jesari-git/tt10-gus16-jarias/docs/GUS16_tt.pdf

## GUS16-v6 in Silicon

Jesús Arias Alvarez

## 1 Tiny Tapeout projects

Tiny Tapeout provides the education community with an affordable way of making chips, but there are also some constraints you have to be aware of when designing a digital system for these Tiny Tapeout runs, like:

- No memory blocks. On-chip memory takes a lot of silicon space. If your design requires some decent amount of memory (like 1 kilobyte) it is better to attach another memory chip outside the prototype.
- Limited number of pins. Your design gets a clock and reset signals, along with:

– 8 input pins

– 8 output pins

– 8 bidirectional pins

And that’s all.

- Small silicon area. The prototype space is divided into an array of 160×110µm

2
tiles and your design
must fit into an small number of tiles, ideally just one.

## 2 The GUS16-tt system

The Tiny Tapeout constraints were quite challenging, and in order to meet them this GUS16 system has some peculiarities, like:

- The internal memory is reduced to a tiny 32-word ROM, enough space for a simple serial bootloader. ROM memories are combinatorial circuits that can be built with simple logic gates (with an small number of them, let’s hope...)
- An external RAM is mandatory, but the number of pins is also limited. An SPI RAM will require only 4 pins, but it is painfully slow, so here a different solution is presented: A conventional SRAM with an 8-bit data bus and with latches for its address bits. This solution will use the 8 bidirectional pins along with 5 output pins for control. The bad side of this is the 4 clock cycles needed for each memory read or write that results in a processor clock frequency divided by four. Still, this is a lot better than the 48 cycles required for an SPI RAM like the 23LC1024, and leaves 3 output pins and 8 input pins still free.

In figure 1 the blocks of a simple computer built around this prototype chip are displayed. The chip includes a GUS16-v6 core along with several peripherals, the boot ROM, and the external memory interface. We should remark:

- The CPU has an stoppable clock and can be halted when waiting for UART data.

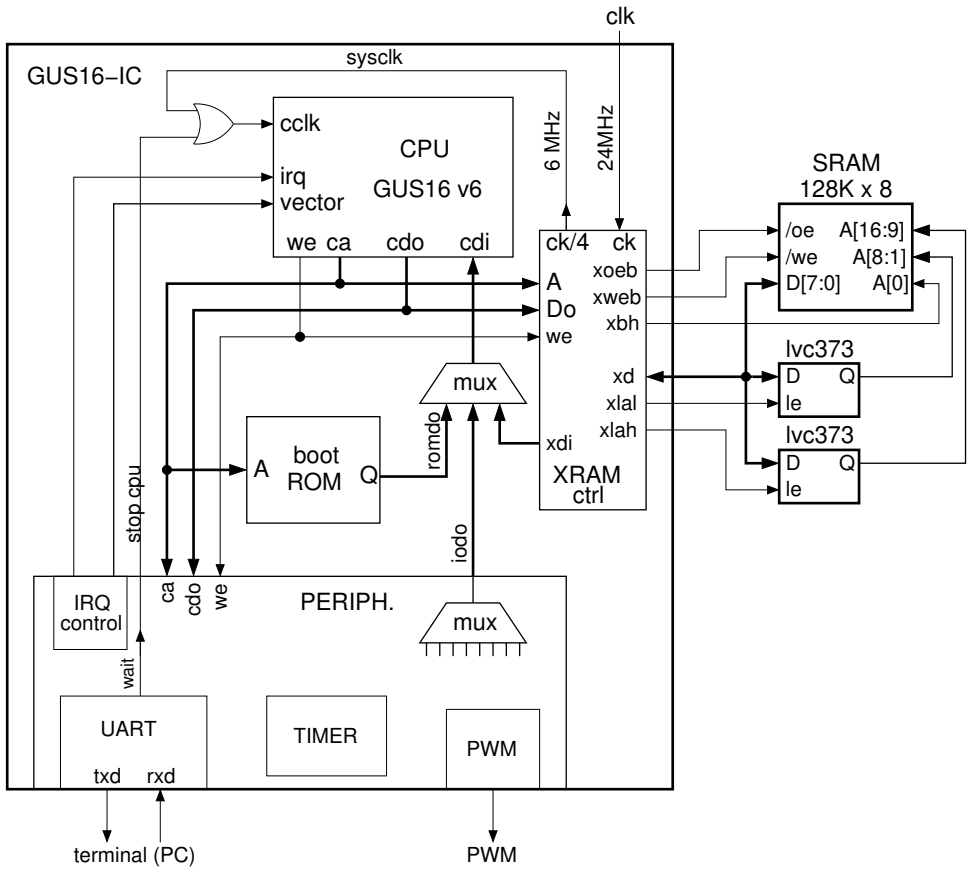
[picture p1: figure]
TIMER; mux; cclk; cdi; vector; irq; CPU GUS16 v6 romdo; cdo; SRAM 128K x 8; xbh; xlal xlah; xweb; xoeb; lvc373; mux iodo; terminal (PC) wait; IRQ control; PERIPH.; GUS16−IC; XRAM ctrl; stop cpu; UART; txd; rxd; PWM; sysclk; boot ROM Q; xdi ⁶ MHz; 24MHz; clk

Figure 1: Block diagram of the GUSY computer.

- A simple UART with a fixed baud rate (default 115200bps) is included as the main computer interface. This peripheral is also a bit peculiar because it can stop the CPU clock. This was done in order to simplify the bootloader code: If the receiver register is read when there is no data available the program execution stalls until a new character arrives at the receiver. In this way there is no need to keep polling an status register until a data available flag is set and the code is more compact. The same happens with the transmitter: if the transmitter register gets written while an old data is still being transmitted the CPU stalls until the new character can be written. Of course, the related flags can also be read in an status register and the usual polling routines do not result in stalls (this can be desirable if there are interrupts enabled).
- A 16-bit timer counter is also included, mainly for profiling and interrupt generation. It includes a fixed prescaler divider that results in a 1 MHz counter frequency (it counts microseconds).
- A simple PWM output (audio DAC) is included.
- The core has five interrupt sources with independent vectors. These sources can be enabled by writing the Interrupt Enable register with ones (all its bits are zeroes after reset). The interrupts have a fixed priority order.

### 2.1 The external memory interface

The GUS16 core has 16-bit address and data buses, but we only got 8 bits for a bidirectional bus where all addresses and data has to pass through. This means that any memory access, read or write, has to take four cycles (see figure 2): First, the low 8 bits of the memory address are presented on the bus and the “latch address

1 | 2 | 3
A[7:0] | A[15:8]

xlah

xlal

xd[7:0]

xbh

sysclk

clk

0

READ CYCLE

high−Z

1 | 2 | 3
A[7:0] | A[15:8] | D[7:0] | D[15:8]

xweb

xlah

xlal

xd[7:0]

xbh

sysclk

clk

WRITE CYCLE

0

xoeb

low−byte
(from external RAM)

high−byte

Figure 2: External memory timing for write and read cycles

low”, ’xlal’, signal is asserted. Then follows the high 8 bits of the address with ’xlah’ active. These address bytes must be stored into latches (the 74lvc373 is a good part for this) and presented to the SRAM address inputs. But there is still an extra address bit, ’xbh’ (bus high), that selects between the low or high bytes of 16-bit words.
After the two address cycles come another two data cycles where the low and high bytes of a 16-bit word are read or stored into the external RAM. During reads the bus pins are floating and, thus, the external RAM is able to put its data into the bus, while for writes the bus outputs the low and high bytes to be written into the RAM.
Because the GUS16 core is reading or writing the memory every clock cycle it makes no sense to run the core with a frequency higher than 1/4 of the maximum clock frequency for the external RAM, so, the system clock is just one cycle every 4 memory cycles.

### 2.2 Boot ROM

The boot ROM is just a simple combinational block with 5 address inputs and 16 data outputs. The synthesis tool translates it into a digital circuit that depends on the ROM contents. The bootloader program includes 22 instructions and is listed in figure 3. It first waits until an ’L’ is received, then it reads 6 bytes with the program image information (destination address, size, and start address), reads the whole program, and jumps to its starting address.
The program images that are loaded through the serial port must be preceded by an 8-byte header, LSB bytes first:
LSB | MSB | Comments
0xFF | 0x4C (’L’) | 0xFF is a byte-sync character for UART RX
Loading Address
Size (words) | | not including this header
Starting Address | | 0x0000 means enter bootloader again

The first 0xFF byte isn’t strictly needed, but it is included in order to have an even number of bytes in the header, and to ease the correct reception of the following data as none of its data bits could be misunderstood as

0000 - | | ORG 0 | | ; RESET
0000 - 5722 | INICIO: LDI | R7,UARTDAT
0001 - 60E0 | BUC1: | LD | R0,(R7) | ; Blocking read
0002 - 484C | | CMPI | R0,'L'
0003 - 9FFD | | JNZ | BUC1
0004 - 68E0 | | ST | (R7),R0 | ; Echo 'L'
0005 - 700C | | JAL | GETW
0006 - 0A01 | | OR | R2,R0,R0 | ; ADDRESS
0007 - 700A | | JAL | GETW | ; + WORD COUNT
0008 - 0340 | | ADD | R3,R2,R0 | ; = LAST ADDRESS
0009 - 7008 | | JAL | GETW
000A - 0C01 | | OR | R4,R0,R0 | ; ENTRY POINT
000B - F003 | | JR | BUC2E
000C -
000C - 7005 | BUC2: | JAL | GETW | ; Get word
000D - 6840 | | ST | (R2),R0 | ; and store it
000E - 1201 | | ADDI | R2,1 | ; next address
000F - 0069 | BUC2E: SUB | R0,R3,R2 | ; COMPARE ADDRESS
0010 - 9FFB | | JNZ | BUC2
0011 - 58F2 | | JIND | R4 | ; Jump to code
0012 -
0012 - 60E0 | GETW: | LD | R0,(R7) | ; Blocking read
0013 - 61E0 | | LD | R1,(R7) | ; Blocking read
0014 - 5944 | | RORI | R1,R1,8
0015 - 0805 | | OR | R0,R0,R1
0016 - 58FA | | JIND | R6

Figure 3: Listing of the bootloader code

an start bit. Also, the ’Starting Address’ word can be made zero and the bootloader jumps to itself after loading a data block. In this way more than a single data block can be loaded before jumping to the program code.

### 2.3 Memory map

The GUS16 CPU can address up to 64Kword. In this address space the boot ROM, the external RAM, and the I/O registers have to be mapped. In figure 4 the relevant areas of the memory map are shown. The first 32 words are mapped to the boot ROM, followed by another 32 words reserved for I/O registers. The external RAM occupies all the memory space and gets read and written along with the ROM and the peripherals, but its data is ignored by the CPU for these low addresses.
In figure 4 the registers of the included peripherals are also shown. These peripherals are:

### 2.3.1 UART

The UART is a simple one with a fixed speed of 115200 bps and a fixed data format of 8 bits, 1 stop bit and no parity. There are two data registers for receiver and transmitter and several flags. The data registers have 8 bits and therefore the bits 8 to 15 are read as zero and ignored on writes. The receiver include a holding register (1-byte FIFO) in addition to its corresponding shifting register. The flags can be read in the PFLAGS register, where all the peripheral flags are located, and are:

- RXAV: Receiver data available. Set to one when a character is received and cleared by reading the UART data register. This flag can request an interrupt when set.
- TXRDY: Transmitter ready to accept data. Set to one when the transmitter is idle. This flag can request an interrupt when set.
- OVE: Overrun. Set to one if a character is received while RXAV was active.
- FE: Frame error. Set to one when a character is received with its stop bit as zero.

The block diagrams for the transmitter and receiver are presented in figure 5. The transmitter includes a clock divider, “baud counter”, that gets reset on writes, a 9-bit shift register, and a bit counter. ’nstop’ is hardwired to

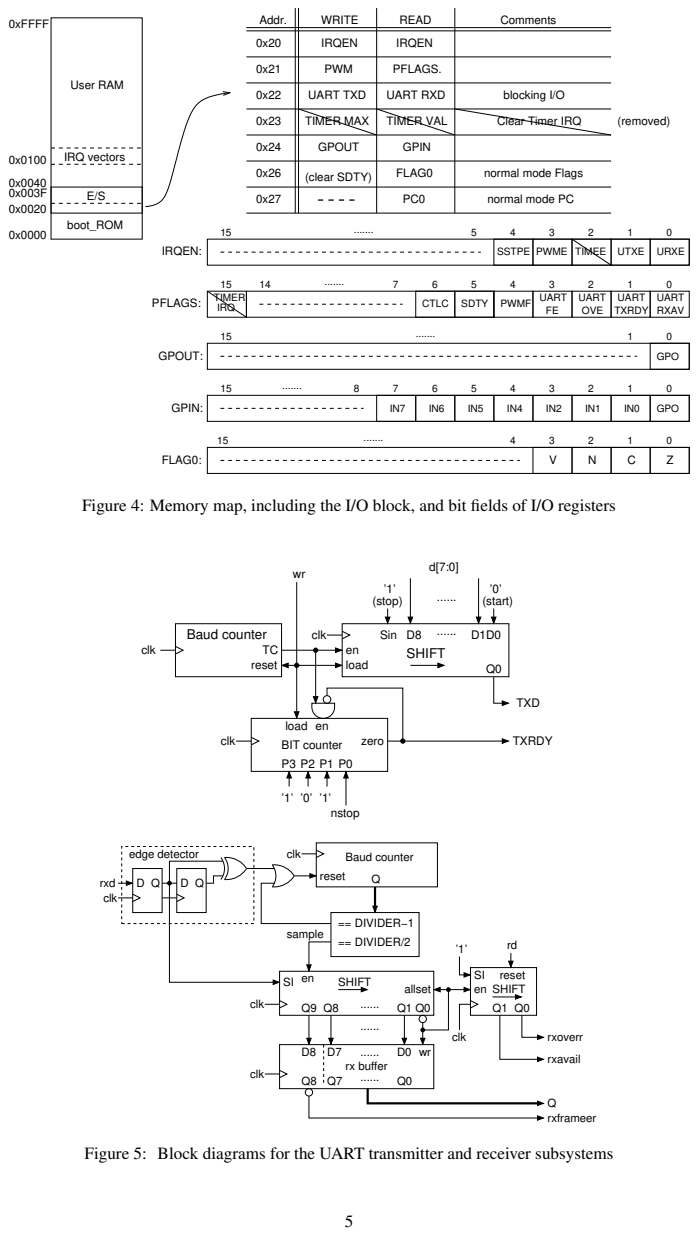
[picture p2: page 5]
IRQEN; Addr.; WRITE; READ; UART TXD; 0xFFFF; IRQ vectors; PFLAGS.; Comments; boot_ROM; UART RXD; PWM; TIMER MAX; TIMER VAL; GPINGPOUT; User RAM; FLAG0; IRQEN:; TIMER IRQ; PFLAGS:; UART; TXRDY RXAV; UTXE; URXETIMEE; OVEFE; PWME; PWMF; GPOUT:; GPIN:; GPO; SSTPE; CFLAG0:; SDTY; (clear SDTY); CTLC; blocking I/O; (removed); TCclk; clk; TXD; TXRDY; loadreset; zero; SHIFT; BIT counter; load; Baud counter; Sin; (stop); (start); ’1’ ’0’ ’1’ nstop; == DIVIDER/2; reset; == DIVIDER−1; allset; reset SHIFT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

Clear Timer IRQ

normal mode Flags

normal mode PC

UART UART UART

Figure 4: Memory map, including the I/O block, and bit fields of I/O registers

rxavail Figure 5: Block diagrams for the UART transmitter and receiver subsystems

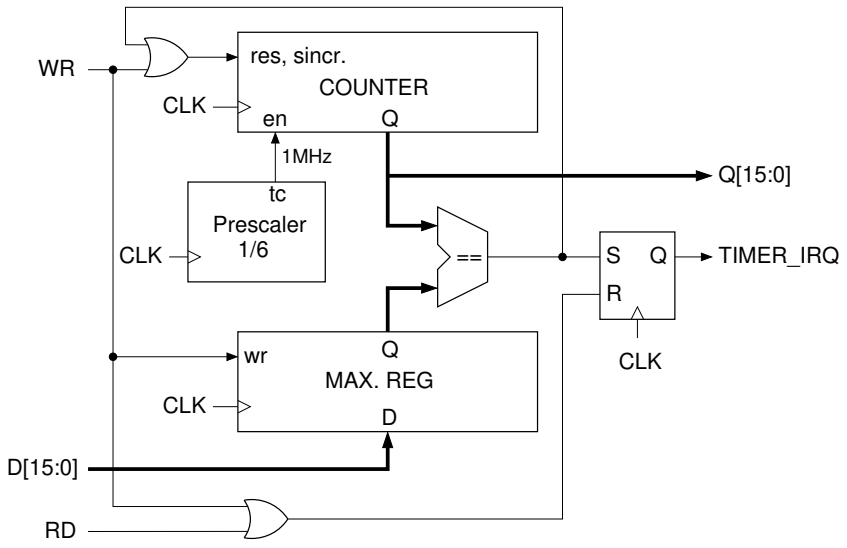
[picture p3: figure]
CLK; res, sincr.; COUNTER; MAX. REG; Prescaler; 1MHz; TIMER_IRQ

Figure 6: Block diagram of the Timer peripheral

’0’, so, only one stop bit is transmitted. The receiver is a bit more complex. It also includes a clock divider that get reset every time an edge is present in the input data waveform. A ’sample’ pulse is also generated when the clock divider reaches its middle value, meaning the input bits are sampled at the center of their bit time. These bits are shifted into a 10-bit shift register, and when the start bit reaches the LSB position the remaining bits are transferred to the RX buffer, the RX available and RX overrun flags are updated, and the whole shift register is preset synchronously to ’all-ones’.

### 2.3.2 Timer (removed from prototype)

A simple 16-bit timer allows the generation of periodic interrupts. It includes two registers, one of them is the actual counter while the other holds the maximum count (see figure 6). When the counter reaches the value of maximum count on the next cycle it gets loaded with zero and an interrupt flag is set. This flag can be read in the PFLAGS register (bit 15).
A write to the timer register loads the maximum count and also resets the counter while a read returns the current count. A read or write clears the interrupt flag.
A prescaler divider provides a 1MHz effective clock to the timer, so, it counts microseconds.
This peripheral was a bit bulky and was removed from the prototype in order to save some chip area and to fit into two Tiny Tapeout tiles.

### 2.4 PWM

A PWM modulator is included with the intended use of audio generation. Its diagram is shown in figure 7, where the main building block is a binary counter that increments from zero up to 2n −2 (its modulus is 2n −1).

The counter value is compared with the PWM level stored in a holding register, and, when the two values match the output flip-flop gets reset. This flip-flop is also set when the counter value is zero, thus generating the expected PWM waveform at the output. There are two special cases to analyze:

1. PWM level = 0. In this case the output flip-flop gets reset (its reset input has more priority than set) and the PWM output is always low.
2. PWM level = 2n −1. In this case the flip-flop is set but never reset, and the output is always high.

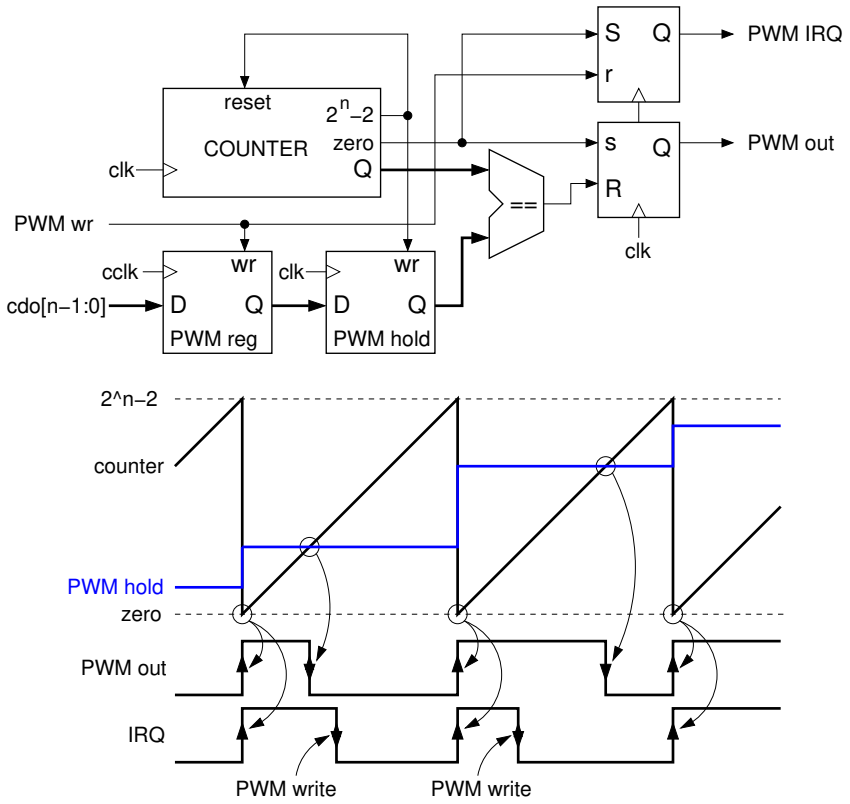
[picture p4: figure]
zero Q; clk; cdo[n−1:0]; PWM wr; PWM out; PWM IRQ; COUNTER; PWM reg; PWM hold; reset; cclk; counter; zero; IRQ; PWM write

Figure 7: PWM modulator and related waveforms

A second flip-flop is used as an interrupt flag. It gets set when the counter equals zero and reset when a new value is stored in the PWM register. This flag can request an interrupt to the core when high and it can also be read at the bit #4 of the ’PFLAGS’ register..
And, finally, there is a holding register between the PWM register and the comparator block. Thanks to this register the output waveform is undisturbed when new PWM values are written. These values are copied to the holding register when the counter changes from its maximun count, 2n −2, to zero.

The number of bits of the PWM generator, ’n’, is selected with a parameter, PWMBITS, that defaults to 8. The PWM carrier frequency is fCLK/(2

n −1), (or 23529Hz for a 6MHz clock and an 8-bit PWM)

### 2.5 Interrupts

In the system there are 5 interrupt sources that are handled with an interrupt-enable register and a 3-bit priority encoder. The GUS16-v6 core has a design parameter, VECTORBASE, that allows the selection of a convenient base address for the interrupt jump table. In our case this address is 0x100 because it is a good idea to reserve the addresses below 0x100 for program variables as these addresses can be loaded into a pointer register with a single LDI instruction (the I/O registers are also mapped into this area for the same reason). The interrupt sources are detailed in the next table:

Source | INTEN bit | Priority | Jump address | Clear with
UART RX | #0 | Highest | 0x0100 | UART data read
UART TX | #1 | | 0x0104 | UART data write
Timer Overflow | #2 | | 0x0108 | Read or write Timer
PWM | #3 | | 0x010c | write PWM
Single Step | #4 | Lowest | 0x0110 | no clear needed

026A: 5700 | LDI | R7,00 | <- PC | Flags: __C_
026B: 5120 | LDI | R1,20
026C: 6020 | LD | R0,(R1) | | R0: 0010
026D: 3808 | ORI | R0,08 | | R1: 00FF
026E: 6820 | ST | (R1),R0 | | R2: FEC3
026F: 5000 | LDI | R0,00 | | R3: 0000
0270: 5140 | LDI | R1,40 | | R4: 026A
0271: 6822 | ST | (R1+2),R0 | | R5: 0020
0272: 7F14 | JAL | 0187 | | R6: FF54
0273: 7F49 | JAL | 01BD | | R7: 0000
0274: F12A | JR | 039F
0275: 7F11 | JAL | 0187
0276: 7F46 | JAL | 01BD | | Break: 0000
0277: 7ED2 | JAL | 014A
0278: 7ED1 | JAL | 014A
0279: 7ED0 | JAL | 014A
027A: 3007 | ANDI | R0,07
027B: 4807 | CMPI | R0,07
027C: 8FFA | JZ | 0277
027D: 5140 | LDI | R1,40
hcesnrRbdm>
<space> redraw screen
c | Continue (no stop)
e | Execute (w breakpoint)
s | Single step
n | exec until Next instr
r | exec until return (JIND R6)
R | exec until return at higher stack level
b [adr] set Breakpoint
d [adr] Dissasemble
m [adr] Memory dump
hcesnrRbdm>

Figure 8: Screen capture of the debugger, starting ’Ansitris’ and displaying help. (FPGA replica)

### 2.6 Debugging support

The single-step interrupt is a little peculiar because it is triggered as soon as the core is running in normal mode when enabled with bit #4 set in the IRQEN register (the interrupt request signal is the complement of the actual core mode). Therefore, after returning from a previous interrupt only a single instruction from the user program is executed before jumping to the interrupt routine again. That interrupt routine can display the contents of the core registers and await an user action before moving to the next instruction. The values of the normal mode PC and flags are also available at two I/O registers, and thanks to this a full-featured debugger can be written (see screenshot in figure 8).
In order to help the debugger to avoid erasing the application’s screen an additional flag, Screen-dirty (SDTY), was added to the PFLAGS register. This flag is set on writes to the UART transmitter and cleared on writes to address 0x26 (the value written is ignored). In this way, if the program being debugged prints some-thing on the serial terminal the debugger knows it and avoids overwriting the screen after hitting a breakpoint. And a last flag, CTLC, is also set if we get a “Ctrl-C” character (ASCII 0x03) in the UART receiver, so, we can know if this special character has been received without reading the UART RXD register. This avoids disturbing the reception of regular characters when checking for a break in the debugger.
