jesari-git/tt10-gus16-jarias/memory_board/Mem_Board_3D1.pdf

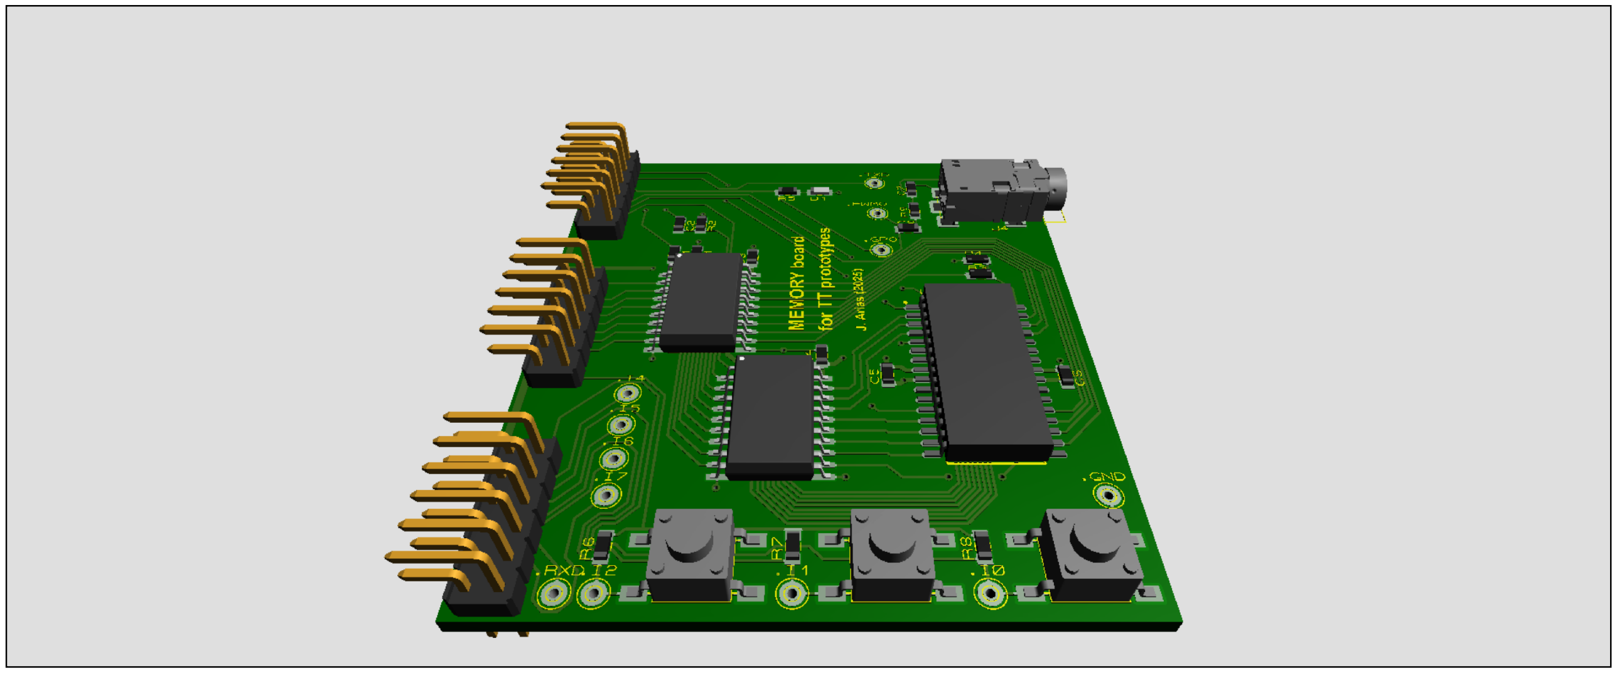
[picture p5: figure]
