jesari-git/tt10-gus16-jarias/memory_board/Mem_Board_SCHEMATIC.pdf

J1

J2

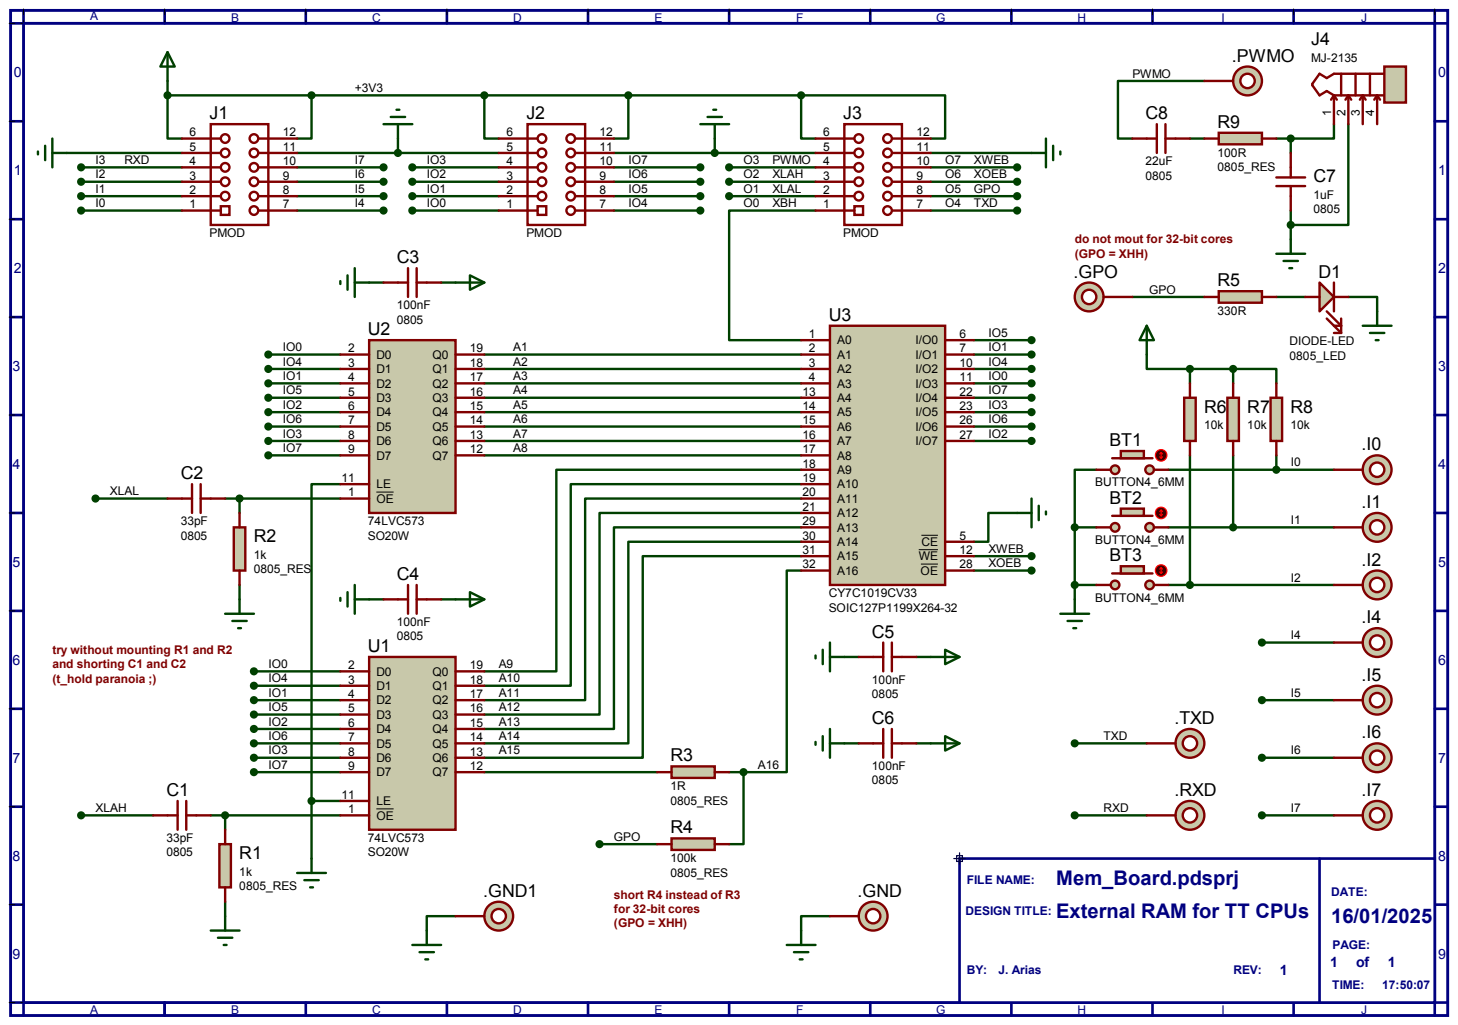
[picture p6: page 1]

do not mout for 32-bit cores
(GPO = XHH)
.GPO

try without mounting R1 and R2
and shorting C1 and C2
(t_hold paranoia ;)

FILE NAME:
DESIGN TITLE: External RAM for TT CPUs
