jesari-git/tt10-gus16-jarias/memory_board/Mem_Board_LAYOUT_top.pdf

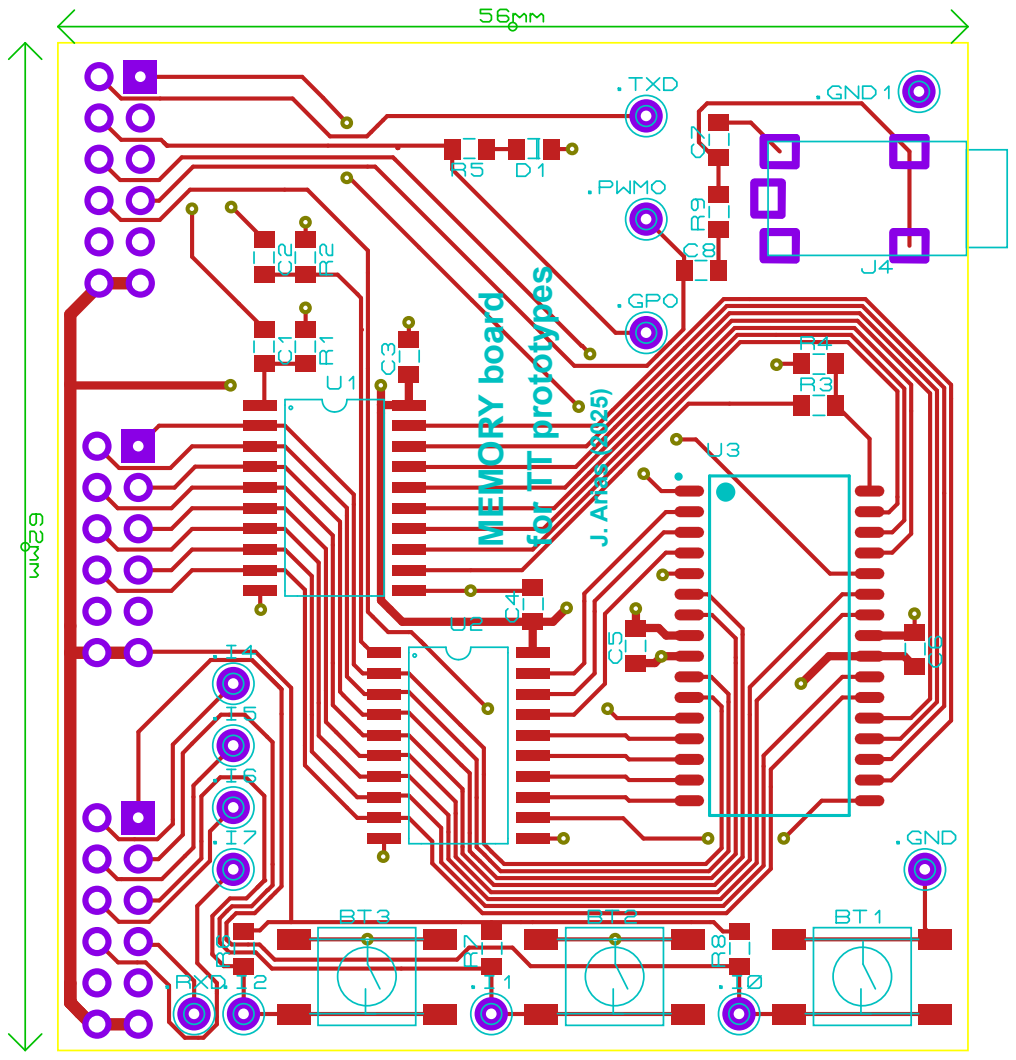
[picture p7: page 1]
MEMORY board; J. Arias (2025)

for TT prototypes
