jesari-git/tt10-gus16-jarias/memory_board/Mem_Board_LAYOUT_bottom.pdf

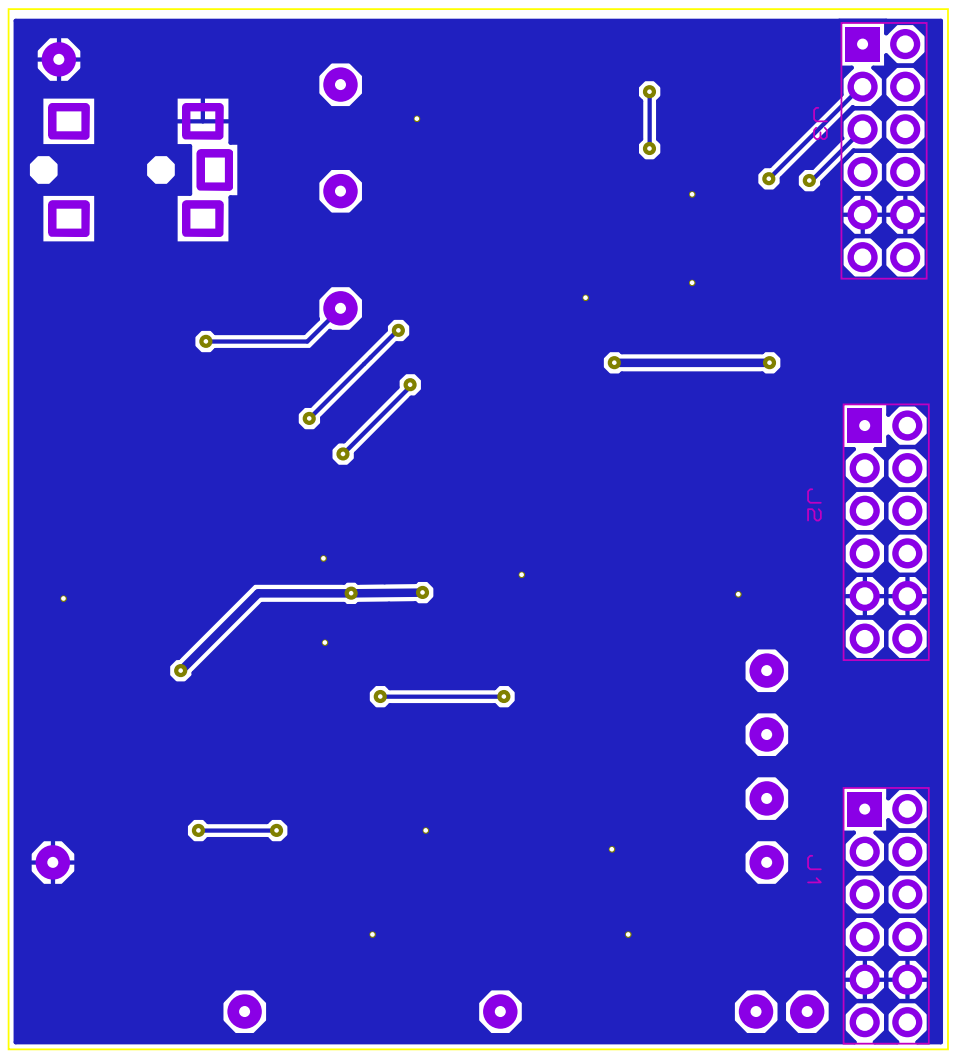
[picture p8: page 1]
