jesari-git/tt10-gus16-jarias/test/test.py

# SPDX-FileCopyrightText: © 2024 Tiny Tapeout
# SPDX-License-Identifier: Apache-2.0

import cocotb
from cocotb.clock import Clock
from cocotb.triggers import ClockCycles


@cocotb.test()
async def test_project(dut):
    dut._log.info("Start")

    # Set the clock period to 41 us (24 MHz)
    clock = Clock(dut.clk, 41, units="ns")
    cocotb.start_soon(clock.start())

    # Reset
    dut._log.info("Reset")
    dut.ena.value = 1
    dut.ui_in.value = 8
    dut.uio_in.value = 0
    dut.rst_n.value = 0
    await ClockCycles(dut.clk, 10)
    dut.rst_n.value = 1

    dut._log.info("Test project behavior")

    # Set the input values you want to test
    dut.ui_in.value = 8
    #dut.uio_in.value = 30
    await ClockCycles(dut.clk, 208)
    
    dut.ui_in.value = 0
    await ClockCycles(dut.clk, 208)
    dut.ui_in.value = 8
    await ClockCycles(dut.clk, 208)
    dut.ui_in.value = 8
    await ClockCycles(dut.clk, 208)
    dut.ui_in.value = 8
    await ClockCycles(dut.clk, 208)
    dut.ui_in.value = 8
    await ClockCycles(dut.clk, 208)
    dut.ui_in.value = 8
    await ClockCycles(dut.clk, 208)
    dut.ui_in.value = 8
    await ClockCycles(dut.clk, 208)
    dut.ui_in.value = 8
    await ClockCycles(dut.clk, 208)
    dut.ui_in.value = 8
    await ClockCycles(dut.clk, 208)
    dut.ui_in.value = 8
    await ClockCycles(dut.clk, 208)

    dut.ui_in.value = 0
    await ClockCycles(dut.clk, 208)
    dut.ui_in.value = 0
    await ClockCycles(dut.clk, 208)
    dut.ui_in.value = 0
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
    # Change it to match the actual expected output of your module:
    assert dut.rst_n.value == 1

    # Keep testing the module by  changing the input values, waiting for
    # one or more clock cycles, and asserting the expected output values.
