jesari-git/tt10-gus16-jarias/(commit log)

2024-10-22 Add files via upload
    PWM 1/4 freq
2024-10-22 asyn reset rx sh
    [project.v]
2024-10-23 reset async uart_txdiv
2024-10-23 ASYNC reset en UART.rxdiv
    [project.v]
2024-10-25 PWM glitch removed
2024-11-07 bug corrected in assembler (value range in expressions)
    [gus6asm.c]
2024-11-12 Bug corrections in tools
    [gus6dasm.c, gus6emu.c]
2024-11-18 race condition in IRQs fixed
    [project.v]
2024-11-18 assembler: long lines
2025-01-16 Memory board added
2025-01-17 New Single-Step interrupt
